skot/AntHat/readme.md

## AntHat
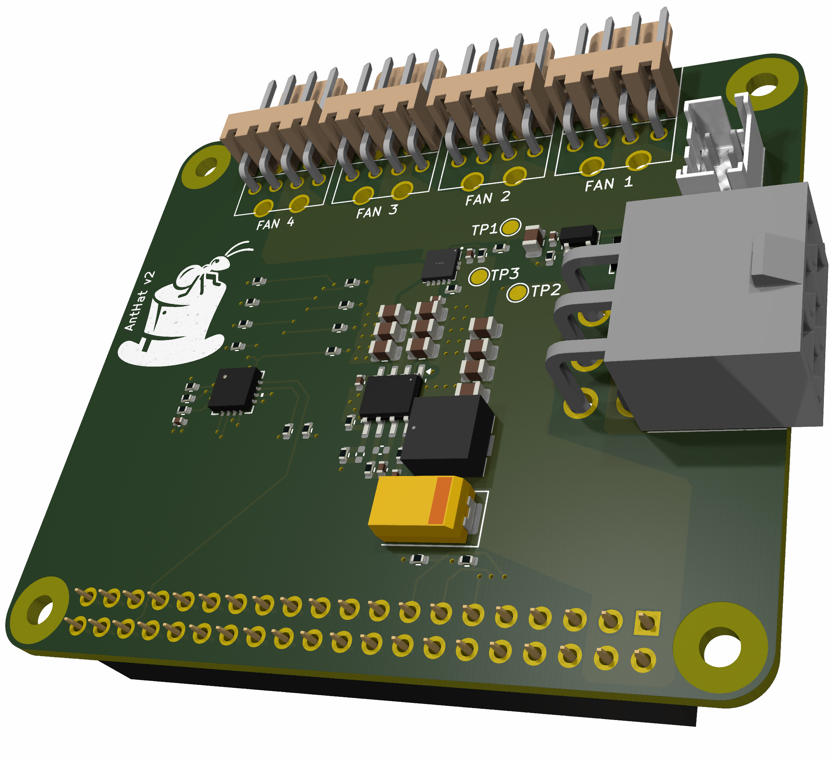
[picture p1: doc/render.png]
AntHat render


The AntHat is a HAT for a RaspberryPi to control Antminer fans and PSU. Best used with the aditBoard to fully control the miner.
