skot/AntHat/AntHat.kicad_pcb

## KiCad design AntHat.kicad_pcb (2025-01-23)

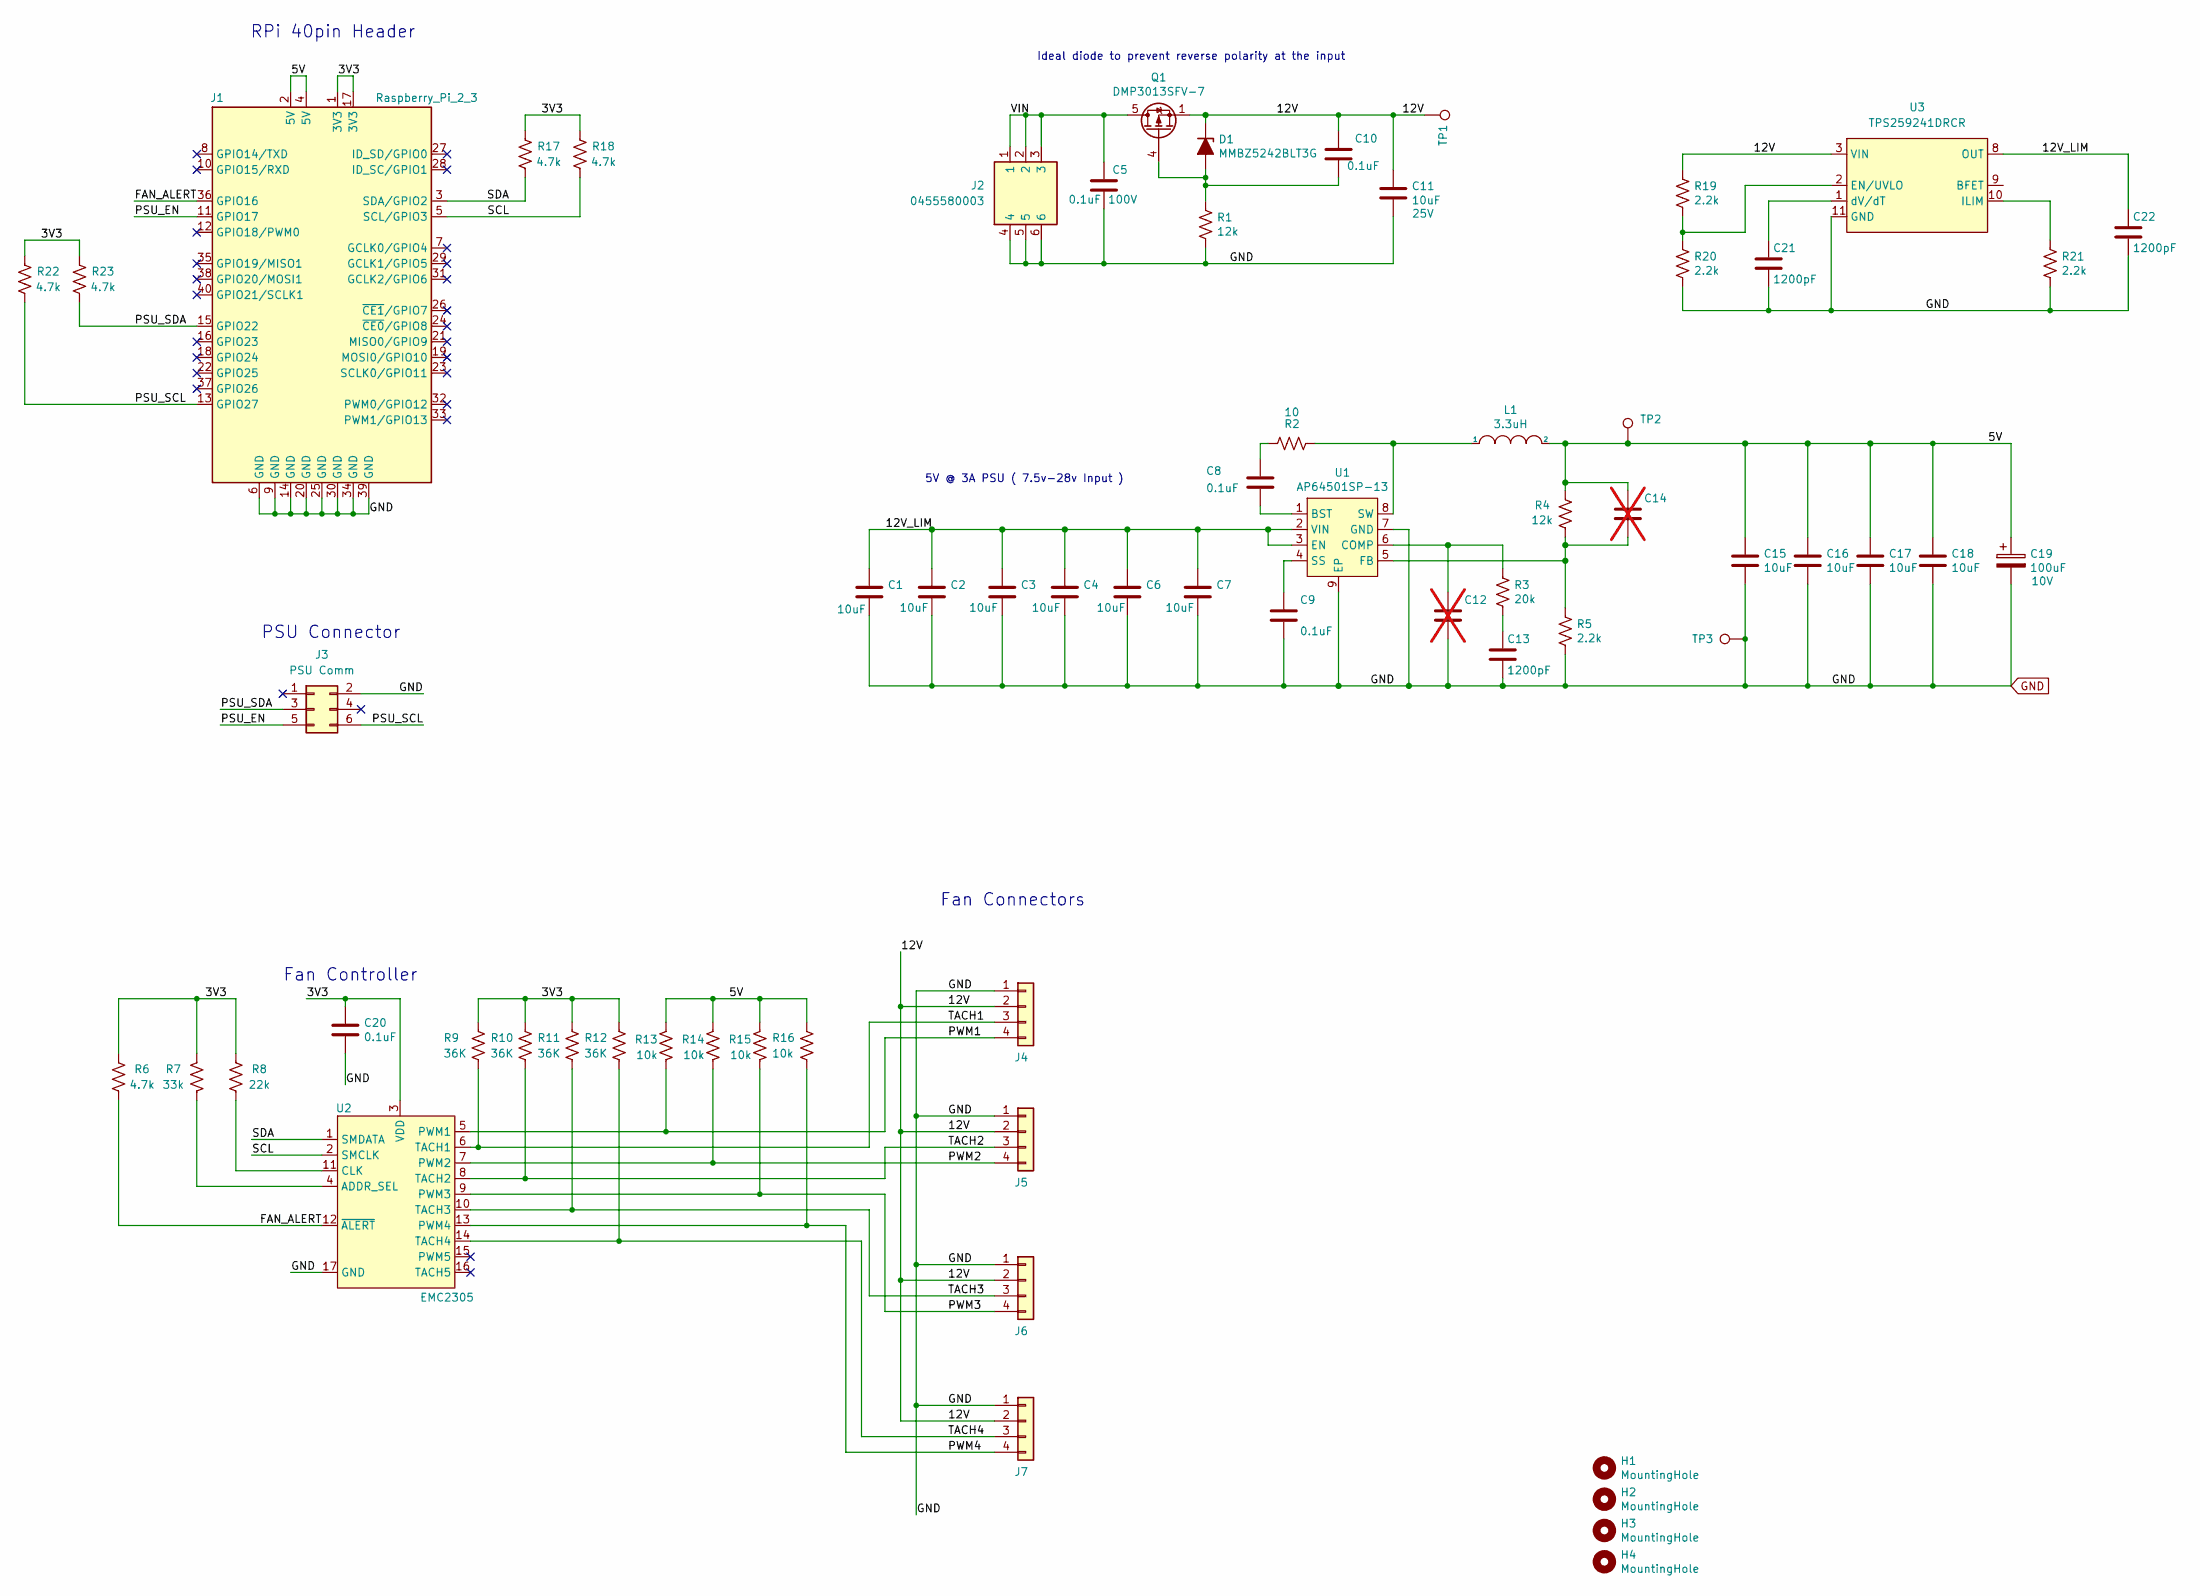
[picture p2: schematic AntHat.kicad_sch]

Parts:
C1, C2, C3, C4, C6, C7, C11, C15, C16, C17, C18: 10uF; C_0805_2012Metric; Voltage 25V; PARTNO GRM21BC8YA106ME11L; LCSC C15850
C5: 0.1uF; C_0805_2012Metric; Voltage 100V; LCSC C28233
C8, C9, C10, C20: 0.1uF; C_0402_1005Metric; Voltage 25V; PARTNO GRM155R71C104KA88J; LCSC C52923
C12, C14: C_0402_1005Metric; not fitted
C13, C22: 1200pF; C_0402_1005Metric; Voltage 25V; PARTNO GCM155R71H122KA37D; LCSC C16529
C19: 100uF; CP_EIA-7343-31_Kemet-D; Voltage 10V; PARTNO TAJD107K010RNJ; LCSC C7222
C21: 1200pF; C_0402_1005Metric; Voltage 25V; PARTNO GCM155R71H122KA37D; LCSC C107021
D1: MMBZ5242BLT3G; D_SOT-23_ANK; PARTNO LBZX84C12LT1G; LCSC C12773
H1, H2, H3, H4: MountingHole; MountingHole_2.7mm_M2.5
J1: Raspberry_Pi_2_3; ESQ-120-14-T-D; PARTNO PPPC202LFBN-RC; LCSC C2977589
J2: 0455580003; PARTNO 0455580003; LCSC C492365
J3: PSU Comm; CONN-TH_6P-P2.00_PHD-2X3A; PARTNO SWR204-NRTN-D03-ST-GA; LCSC C2845614
J4, J5: 61900411021; MOLEX_1x4_2x2_combo; PARTNO 61900411021; LCSC C2982043
J6, J7: 0353180420; MOLEX_1x4_2x2_combo; PARTNO 0353180420; LCSC C54909
L1: 3.3uH; IND-SMD_L5.7-W5.2; PARTNO SRP5030T-3R3M; LCSC C189931
Q1: DMP3013SFV-7; Diodes_PowerDI3333-8; PARTNO DMP3013SFV-7; LCSC C264098
R1, R4: 12k; R_0402_1005Metric; PARTNO RC0402FR-0712KL; LCSC C25752
R2: 10; R_0402_1005Metric; PARTNO RC0402FR-0710RL; LCSC C25077
R3: 20k; R_0402_1005Metric; PARTNO RC0402FR-0720KL; LCSC C25765
R5, R19, R20, R21: 2.2k; R_0402_1005Metric; PARTNO RC0402FR-072K2L; LCSC C25879
R6, R17, R18, R22, R23: 4.7k; R_0402_1005Metric; PARTNO RC0402FR-074K7L; LCSC C25900
R7: 33k; R_0402_1005Metric; PARTNO RC0402FR-0733KL; LCSC C25779
R8: 22k; R_0402_1005Metric; PARTNO RC0402FR-0722KL; LCSC C25768
R9, R10, R11, R12: 36K; R_0402_1005Metric; PARTNO RC0402FR-0736KL; LCSC C137999
R13, R14, R15, R16: 10k; R_0402_1005Metric; PARTNO RC0402FR-0710KL; LCSC C60489
TP1, TP2, TP3: TestPoint; TestPoint_Pad_D1.5mm
U1: AP64501SP-13; SOIC-8-1EP_3.9x4.9mm_P1.27mm_EP2.95x4.9mm_Mask2.71x3.4mm_Th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; PARTNO AP64501SP-13; LCSC C2071517
U2: EMC2305; QFN16_4x4MC_MCH; PARTNO EMC2305-1-AP-TR; LCSC C621415
U3: TPS259241DRCR; VSON-10_L3.0-W3.0-P0.50-TL-EP; PARTNO TPS259241DRCR; LCSC C165131

Connections:
/3V3: C20.1, J1.1 (3V3), J1.17 (3V3), R6.2, R7.2, R8.2, R9.1, R10.1, R11.1, R12.1, R17.2, R18.2, R22.2, R23.2, U2.3 (VDD)
/5V: C14.1, C15.1, C16.1, C17.1, C18.1, C19.1, J1.2 (5V), J1.4 (5V), L1.2, R4.1, R13.1, R14.1, R15.1, R16.1, TP2.1
/12V: C10.1, C11.1, D1.3 (K), J4.2, J5.2, J6.2, J7.2, Q1.1 (S), Q1.2 (S), Q1.3 (S), R19.1, TP1.1, U3.3 (VIN), U3.4 (VIN), U3.5 (VIN)
/12V_LIM: C1.1, C2.1, C3.1, C4.1, C6.1, C7.1, C22.1, U1.2 (VIN), U1.3 (EN), U3.6 (OUT), U3.7 (OUT), U3.8 (OUT)
/FAN_ALERT: J1.36 (GPIO16), R6.1, U2.12 (~ALERT)
/PSU_EN: J1.11 (GPIO17), J3.5
/PSU_SCL: J1.13 (GPIO27), J3.6, R22.1
/PSU_SDA: J1.15 (GPIO22), J3.3, R23.1
/PWM1: J4.4, R13.2, U2.5 (PWM1)
/PWM2: J5.4, R14.2, U2.7 (PWM2)
/PWM3: J6.4, R15.2, U2.9 (PWM3)
/PWM4: J7.4, R16.2, U2.13 (PWM4)
/SCL: J1.5 (SCL/GPIO3), R18.1, U2.2 (SMCLK)
/SDA: J1.3 (SDA/GPIO2), R17.1, U2.1 (SMDATA)
/TACH1: J4.3, R9.2, U2.6 (TACH1)
/TACH2: J5.3, R10.2, U2.8 (TACH2)
/TACH3: J6.3, R11.2, U2.10 (TACH3)
/TACH4: J7.3, R12.2, U2.14 (TACH4)
/VIN: C5.1, J2.1, J2.2, J2.3, Q1.5 (D)
GND: C1.2, C2.2, C3.2, C4.2, C5.2, C6.2, C7.2, C9.2, C11.2, C12.2, C13.2, C15.2, C16.2, C17.2, C18.2, C19.2, C20.2, C21.2, C22.2, J1.6 (GND), J1.9 (GND), J1.14 (GND), J1.20 (GND), J1.25 (GND), J1.30 (GND), J1.34 (GND), J1.39 (GND), J2.4, J2.5, J2.6, J3.2, J4.1, J5.1, J6.1, J7.1, R1.2, R5.2, R20.2, R21.2, TP3.1, U1.7 (GND), U1.9 (EP), U2.17 (GND), U3.11 (GND)
unnamed: C8.1, R2.2
unnamed: C13.1, R3.2
unnamed: C10.2, D1.1 (A), Q1.4 (G), R1.1
unnamed: C8.2, U1.1 (BST)
unnamed: C12.1, R3.1, U1.6 (COMP)
unnamed: C14.2, R4.2, R5.1, U1.5 (FB)
unnamed: C9.1, U1.4 (SS)
unnamed: L1.1, R2.1, U1.8 (SW)
unnamed: R7.1, U2.4 (ADDR_SEL)
unnamed: R8.1, U2.11 (CLK)
unnamed: R19.2, R20.1, U3.2 (EN/UVLO)
unnamed: R21.1, U3.10 (ILIM)
unnamed: C21.1, U3.1 (dV/dT)

Notes on the sheet:
RPi 40pin Header
Ideal diode to prevent reverse polarity at the input
5V @ 3A PSU ( 7.5v-28v Input )
Fan Connectors
PSU Connector
Fan Controller

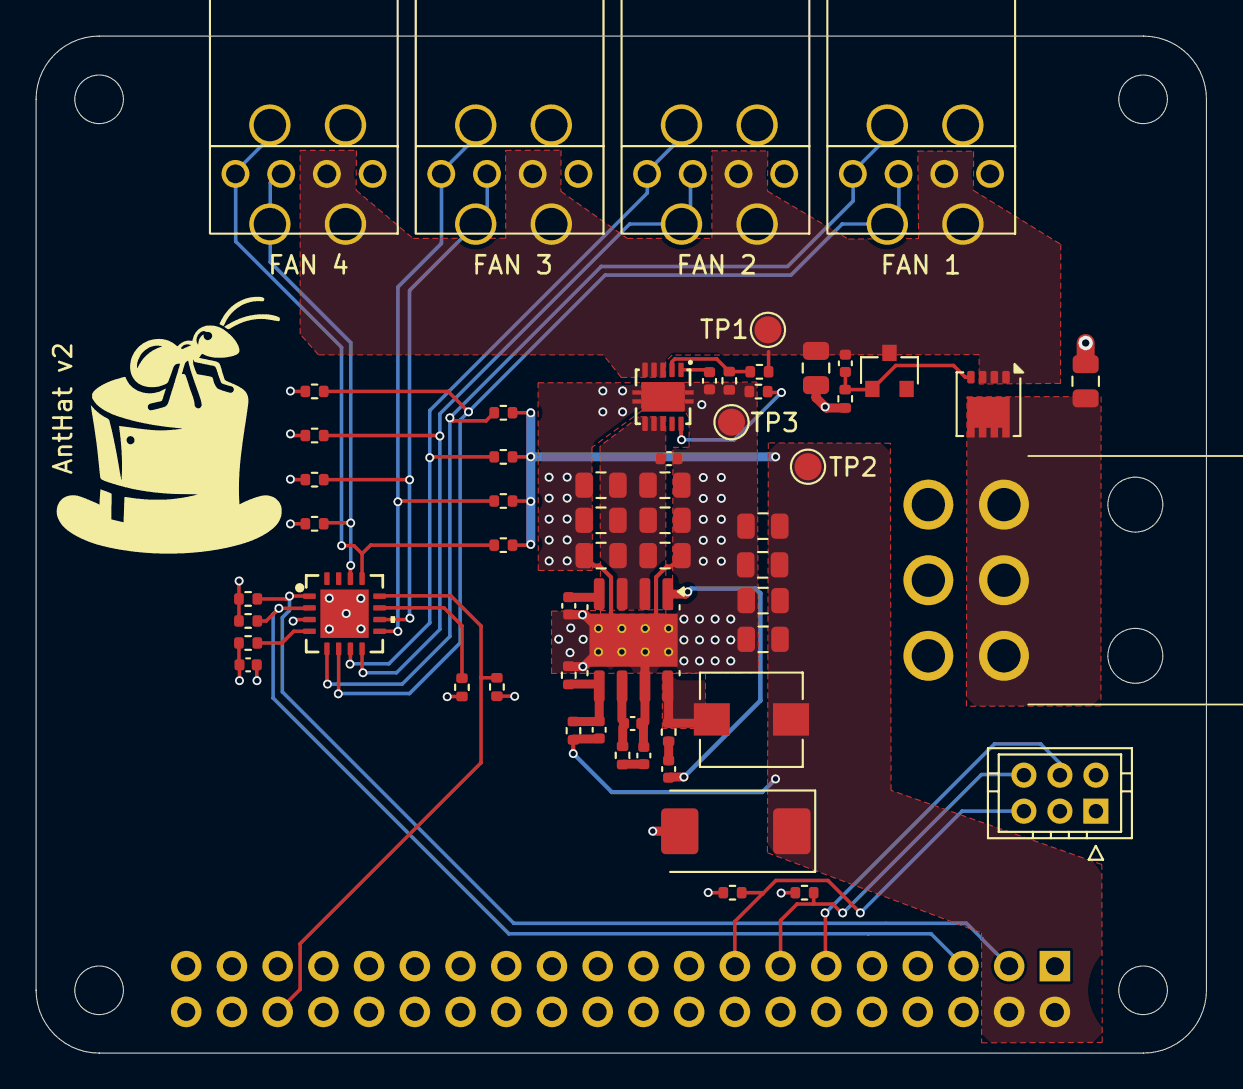
[picture p3: board AntHat.kicad_pcb from above]

Board: 4 copper layers, 65.0 x 56.5 mm, 65 parts (0 on the bottom side), 33 nets.
