skot/AntHat/(threads)

Thread 1 (2024-04-20):

The RPi 40 pin header is flipped 😢

skot, 2024-04-20:
Somehow, miraculously they doesn't fry the RPi, but it certainly isn't going to work at all like this. Don't build v1!
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

skot, 2024-04-20:
nope, it fried the RPi
