skot/AntHat/(commit log)

2024-03-28 initial import
    [AntHat.kicad_pcb, AntHat.kicad_sch]
2024-03-28 finished routing. added logo
    [AntHat.kicad_pcb, AntHat.kicad_sch]
2024-03-29 added the TPS54531 since the AP64501SP-13 isn't on DK. prolly will delete
    [AntHat.kicad_pcb, AntHat.kicad_sch]
2024-03-30 deleted TPS54531. Changed OOS Inductor. DRC passes
    [AntHat.kicad_pcb, AntHat.kicad_sch]
2024-04-04 DRC, ERC and added gerbers
    [AntHat-B_Cu.gbr, AntHat-B_Mask.gbr, AntHat-B_Silkscreen.gbr, AntHat-Edge_Cuts.gbr, AntHat-F_Cu.gbr, AntHat-F_Mask.gbr, AntHat-F_Paste.gbr, AntHat-F_Silkscreen.gbr]
2024-04-20 update iBOM
    [AntHat.kicad_sch]
2024-04-20 add fix for #1
    [AntHat-B_Cu.gbr, AntHat-B_Mask.gbr, AntHat-B_Silkscreen.gbr, AntHat-Edge_Cuts.gbr, AntHat-F_Cu.gbr, AntHat-F_Mask.gbr, AntHat-F_Paste.gbr, AntHat-F_Silkscreen.gbr]
2024-05-06 started to add TPS259241
    [AntHat.kicad_pcb, AntHat.kicad_sch]
2025-01-22 combined the fan connector styles. added some LCSC part numbers. switched PSU I2C over to GPIO for bit banging.
    [AntHat.kicad_pcb, AntHat.kicad_sch]
2025-01-22 add inductor 3d model. update render
    [AntHat.kicad_pcb]
2025-01-22 fixed the footprint & paste on the TPS259241 footprint. Generated and checked gerbers. Generated BOM. Generated iBOM
    [AntHat-B_Cu.gbr, AntHat-B_Mask.gbr, AntHat-B_Silkscreen.gbr, AntHat-Edge_Cuts.gbr, AntHat-F_Cu.gbr, AntHat-F_Mask.gbr, AntHat-F_Paste.gbr, AntHat-F_Silkscreen.gbr]
2025-01-23 added JLCPCB Parts to BOM. changed one CAP to bigger size, cleaned up layout. regenerated gerbers, BOM and CPOS
    [AntHat-B_Cu.gbr, AntHat-B_Mask.gbr, AntHat-B_Silkscreen.gbr, AntHat-Edge_Cuts.gbr, AntHat-F_Cu.gbr, AntHat-F_Mask.gbr, AntHat-F_Paste.gbr, AntHat-F_Silkscreen.gbr]
2025-01-23 updated some OOS LCSC parts. regenerated BOM. added iBOM
    [AntHat.kicad_pcb, AntHat.kicad_sch]
